feg-giessen/ProjectorCtrl/README.md

ProjectorCtrl
=============

(Kudos to [Christoph Schäfer](http://christoph-nils.de/))

Hardware and software for controlling an Epson EMP-TW700 projector.

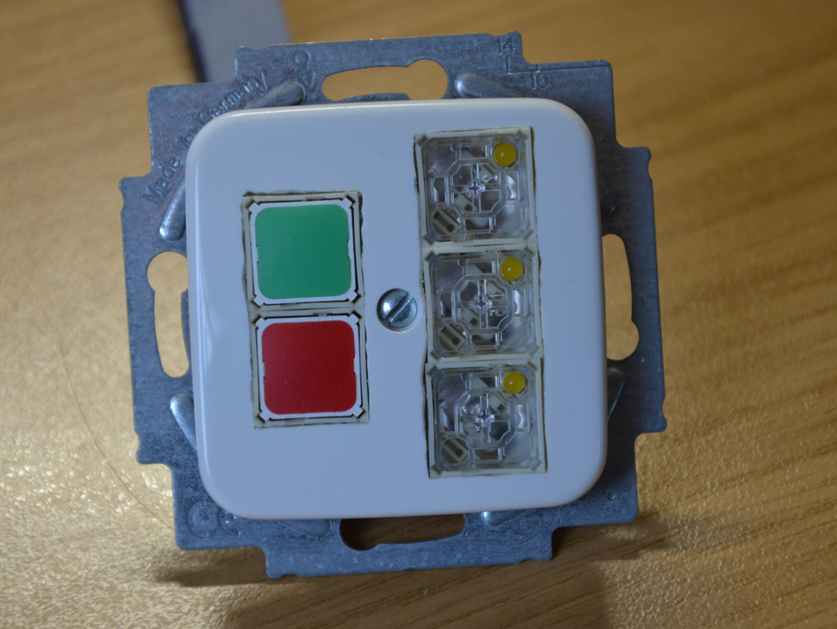
[picture p1: Front.jpg]

Front plate

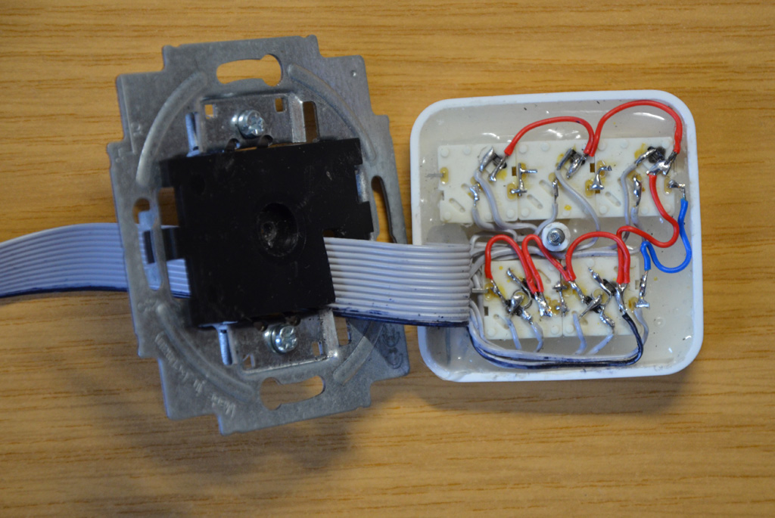
[picture p2: Front2.jpg]

Front plate wiring

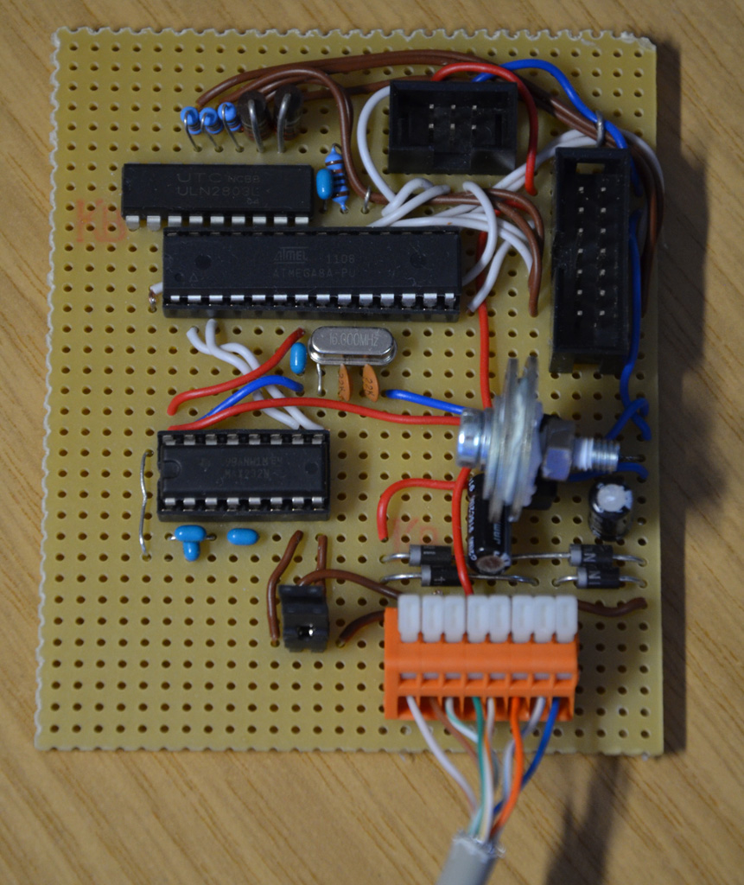
[picture p3: Mainboard.jpg]

Main board

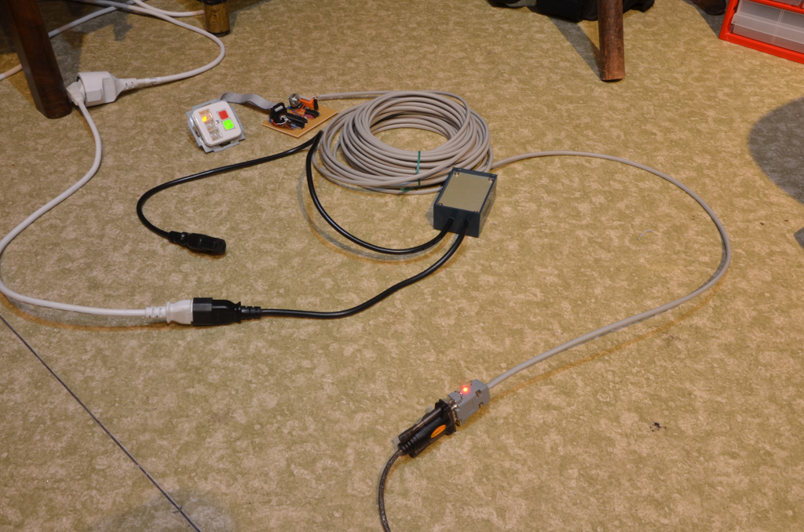
[picture p4: Overview.jpg]

Overview
