feg-giessen/ProjectorCtrl/schematic/README.md

Schematic
=============

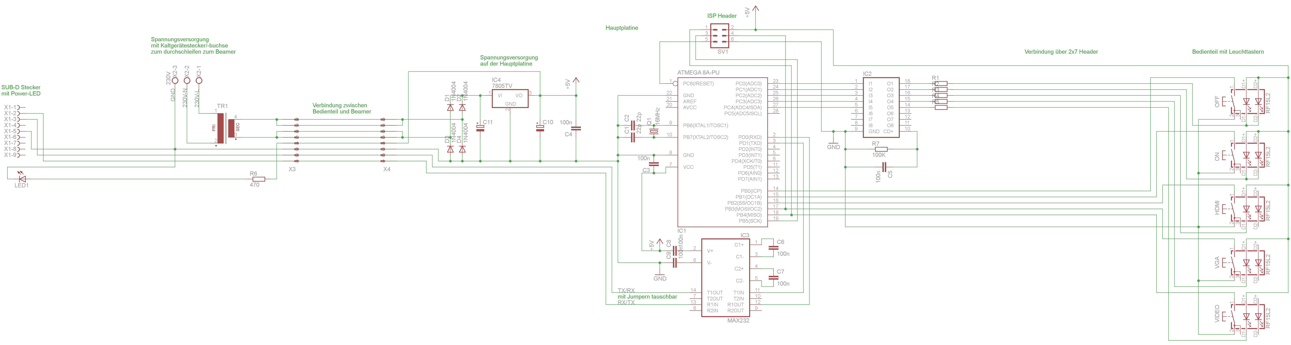
[picture p5: schematic/Schaltplan.png]

Schematic
