feg-giessen/ProjectorCtrl/schematic/Beamersteuerung.sch

## EAGLE design schematic/Beamersteuerung.sch (2013-10-14)

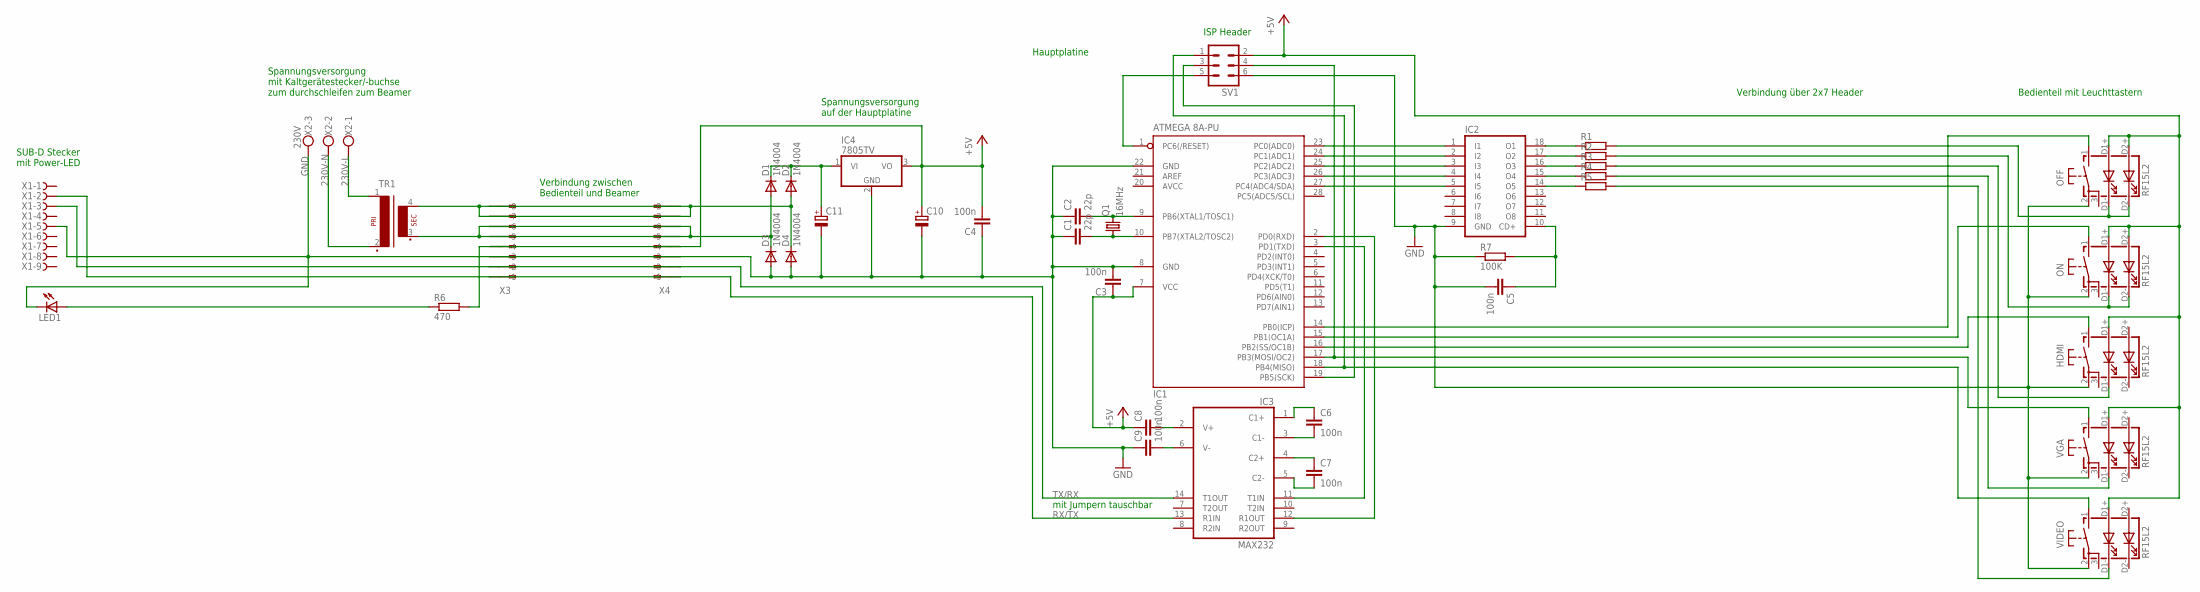
[picture p6: schematic Beamersteuerung.sch]

Parts:
C1, C2: 22p; C025-024X044
C3, C4, C5, C6, C7, C8, C9: 100n; C025-024X044
C10, C11: CPOL-EUE2.5-6; E2,5-6
D1, D2, D3, D4: 1N4004; DO41-10
HDMI: RF15L2
IC1: ATMEGA 8A-PU; DIL28-3
IC2: ULN2803A; DIL18
IC3: MAX232; DIL16
IC4: 7805TV; TO220V
LED1: LED3MM
OFF: RF15L2
ON: RF15L2
Q1: 16MHz; HC49/S
R1, R2, R3, R4, R5: R-EU_0207/12; 0207/12
R6: 470; 0207/12
R7: 100K; 0207/12
SV1: ML6
TR1: VP31
VGA: RF15L2
VIDEO: RF15L2
X1: F09VS; F09V
X2: 230V; W237-103
X3, X4: 233-508

Connections:
230V-L: TR1.1, X2.1
230V-N: TR1.2, X2.2
+5V: C3.1, C4.2, C8.1, C10.+, HDMI.D1+ (A1), IC1.7 (VCC), IC4.3 (VO), OFF.D1+ (A1), OFF.D2+ (A2), ON.D1+ (A1), ON.D2+ (A2), R6.2, SV1.2, VGA.D1+ (A1), VIDEO.D1+ (A1), X3.A4 (-4), X4.A4 (-4)
GND: C1.1, C2.1, C3.2, C4.1, C5.2, C9.1, C10.-, C11.-, D3.A, D4.A, HDMI.2, IC1.8 (GND), IC1.22 (GND), IC2.9 (GND), IC4.2 (GND), LED1.K (C), OFF.2, ON.2, R7.1, SV1.6, VGA.2, VIDEO.2, X1.5, X2.3, X3.A3 (-3), X4.A3 (-3)
unnamed: C6.1, IC3.1 (C1+)
unnamed: C6.2, IC3.3 (C1-)
unnamed: IC1.23 (PC0(ADC0)), IC2.1 (I1)
unnamed: IC1.24 (PC1(ADC1)), IC2.2 (I2)
unnamed: IC1.25 (PC2(ADC2)), IC2.3 (I3)
unnamed: IC1.26 (PC3(ADC3)), IC2.4 (I4)
unnamed: IC1.27 (PC4(ADC4/SDA)), IC2.5 (I5)
unnamed: IC2.18 (O1), R1.1
unnamed: IC2.17 (O2), R2.1
unnamed: IC2.16 (O3), R3.1
unnamed: IC2.15 (O4), R4.1
unnamed: IC2.14 (O5), R5.1
unnamed: C7.1, IC3.4 (C2+)
unnamed: C7.2, IC3.5 (C2-)
unnamed: IC1.3 (PD1(TXD)), IC3.11 (T1IN)
unnamed: OFF.D1- (C1), OFF.D2- (C2), R1.2
unnamed: ON.D1- (C1), ON.D2- (C2), R2.2
unnamed: HDMI.D1- (C1), R3.2
unnamed: R4.2, VGA.D1- (C1)
unnamed: R5.2, VIDEO.D1- (C1)
unnamed: IC1.18 (PB4(MISO)), SV1.1, VIDEO.1 (S)
unnamed: IC1.17 (PB3(MOSI/OC2)), SV1.4, VGA.1 (S)
unnamed: HDMI.1 (S), IC1.16 (PB2(SS/OC1B))
unnamed: IC1.15 (PB1(OC1A)), ON.1 (S)
unnamed: IC1.14 (PB0(ICP)), OFF.1 (S)
unnamed: IC1.1 (PC6(/RESET)), SV1.5
unnamed: IC1.2 (PD0(RXD)), IC3.12 (R1OUT)
unnamed: IC1.19 (PB5(SCK)), SV1.3
unnamed: C5.1, IC2.10 (CD+), R7.2
unnamed: C8.2, IC3.2 (V+)
unnamed: C9.2, IC3.6 (V-)
unnamed: D2.A, D4.C, TR1.4 (S4), X3.A7 (-7), X3.A8 (-8), X4.A7 (-7), X4.A8 (-8)
unnamed: D1.A, D3.C, TR1.3 (S3), X3.A5 (-5), X3.A6 (-6), X4.A5 (-5), X4.A6 (-6)
unnamed: LED1.A, R6.1
unnamed: C2.2, IC1.9 (PB6(XTAL1/TOSC1)), Q1.2
unnamed: C1.2, IC1.10 (PB7(XTAL2/TOSC2)), Q1.1
unnamed: C11.+, D1.C, D2.C, IC4.1 (VI)
RX/TX: IC3.13 (R1IN), X1.2, X3.A1 (-1), X4.A1 (-1)
TX/RX: IC3.14 (T1OUT), X1.3, X3.A2 (-2), X4.A2 (-2)

Notes on the sheet:
SUB-D Stecker mit Power-LED
mit Jumpern tauschbar
Spannungsversorgung mit Kaltgerätestecker/-buchse zum durchschleifen zum Beamer
Hauptplatine
Bedienteil mit Leuchttastern
Verbindung über 2x7 Header
ISP Header
Verbindung zwischen Bedienteil und Beamer
Spannungsversorgung auf der Hauptplatine
